mar-tinchan/MRE-Sensor/PCB/BOM PCB File.xlsx

Comment | Designator | Footprint | JLCPCB Part #
MLX90393ELW-ABA-014-RE | U1 | 16-VFQFN Exposed Pad | C1518192
MLX90393ELW-ABA-011-RE | U2, U3, U4, U5 | 16-VFQFN Exposed Pad | C2654971
CC0402JRX7R7BB104 | C1, C2, C3, C4, C5, C6, C7, C8, C9 | 0402 | C541464
RC0402FR-1310KL | R1, R2 | 0402 | C1858459
SM04B-SRSS-TB(LF)(SN) | J1 | 4 pos, 1 mm pitch | C160404
